eSpark-Backup/getachew-designreview/Docs/Images/Antenna.png

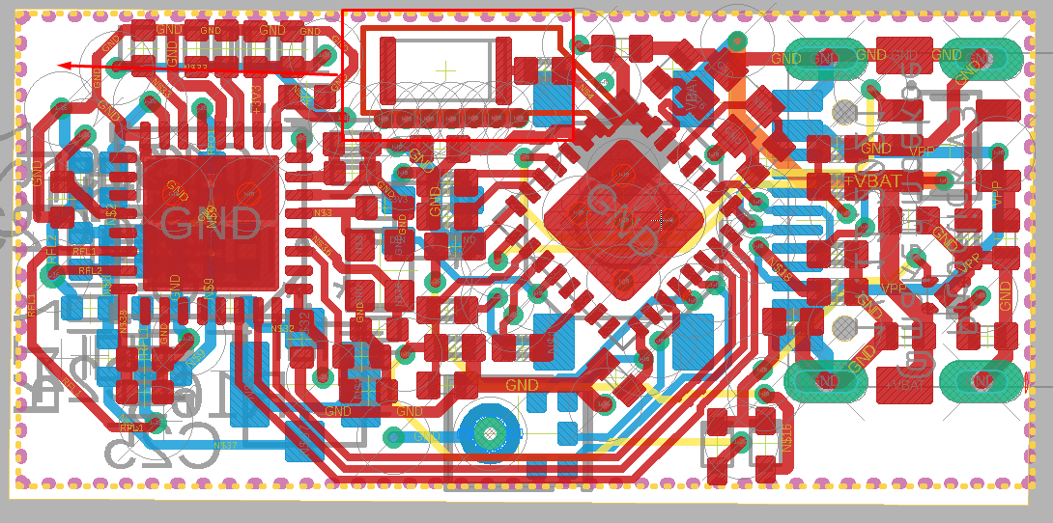
Docs/Images/Antenna.png
