eSpark-Backup/getachew-designreview/Docs/Images/MIC.png

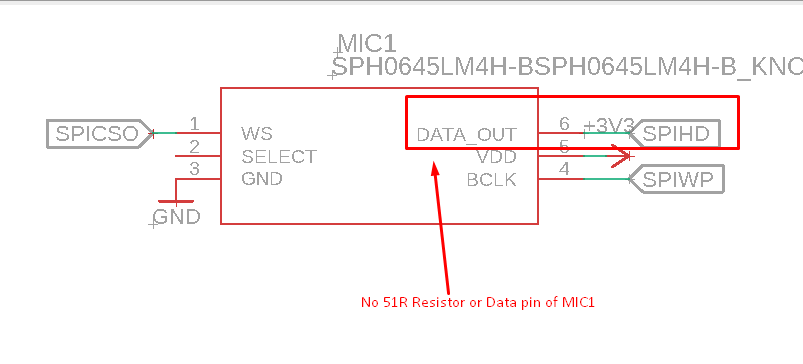
Docs/Images/MIC.png
