eSpark-Backup/getachew-designreview/Docs/Images/R51.png

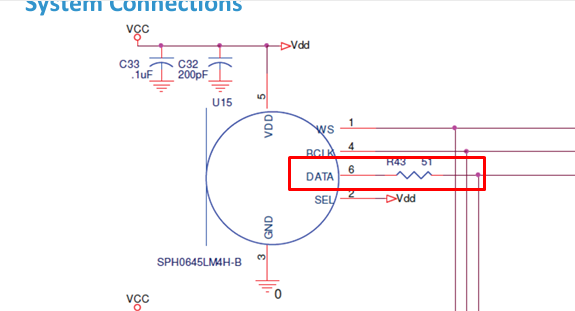
Docs/Images/R51.png
