eSpark-Backup/getachew-designreview/Docs/Images/Shell.png

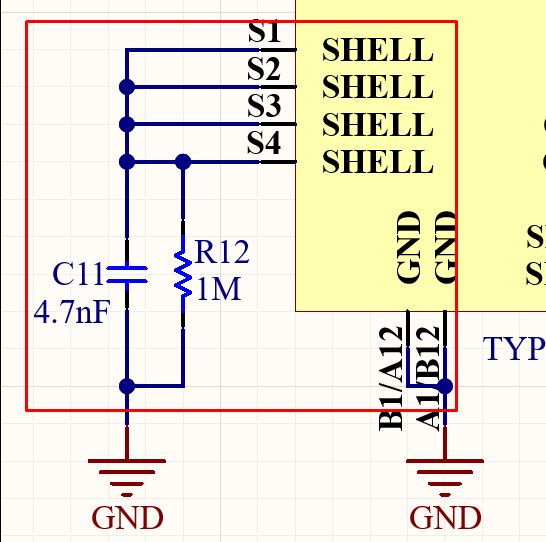
Docs/Images/Shell.png
