eSpark-Backup/getachew-designreview/Docs/Images/Shield.png

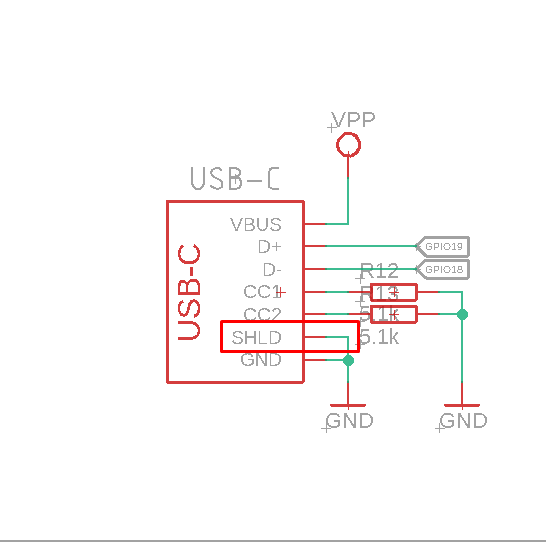
Docs/Images/Shield.png
