eSpark-Backup/getachew-designreview/Design_Files/BOM-esp32-nfc.xlsx

Part | Value | Device | Package | Description | CATEGORY | COPYRIGHT | CURRENT_RATING | DESCRIPTION | MANUFACTURER | MANUFACTURER_PART_NUMBER | MFR_NAME | MPN | OPERATING_TEMP | OPERATING_TEMPERATURE | PART_STATUS | PITCH | POPULARITY | RATING | ROHS_COMPLIANCE | ROHS_COMPLIANT | SERIES | SUB-CATEGORY | SUBCATEGORY | THERMALLOSS | TOLERANCE | TYPE | VALUE | VOLTAGE_RATING
BAT+ | TP/SP-1.5X1.0 | TP/SP-1.5X1.0 | SOLDERPAD_1.5X1.0 | Solderpads/Testpads
BAT- | TP/SP-1.5X1.0 | TP/SP-1.5X1.0 | SOLDERPAD_1.5X1.0 | Solderpads/Testpads
C1 | 1µ | C-EU-0402-WOKEEPOUT_S | C0402_S
C2 | 1µ | C-EU-0402-WOKEEPOUT_S | C0402_S
C3 | 1µ | C-EU-0402-WOKEEPOUT_S | C0402_S
C4 | 1µ | C-EU-0402-WOKEEPOUT_S | C0402_S
C5 |  | C_CHIP-0402(1005-METRIC) | CAPC1005X60 | Capacitor - Generic | Capacitor
C6 |  | C_CHIP-0402(1005-METRIC) | CAPC1005X60 | Capacitor - Generic | Capacitor
C7 | 10µ | C-EU-0402-WOKEEPOUT_S | C0402_S
C8 | 0,1µ | C-EU-0402-WOKEEPOUT_S | C0402_S
C9 | 0,1µ | C-EU-0402-WOKEEPOUT_S | C0402_S
C13 | 1µ | C-EU-0402-WOKEEPOUT_S | C0402_S
C15 |  | C_CHIP-0402(1005-METRIC) | CAPC1005X60 | Capacitor - Generic | Capacitor
C19 |  | C_CHIP-0402(1005-METRIC) | CAPC1005X60 | Capacitor - Generic | Capacitor
C20 | 10p | C-EU-0402-WOKEEPOUT_S | C0402_S
C21 | 10p | C-EU-0402-WOKEEPOUT_S | C0402_S
C22 |  | C_CHIP-0402(1005-METRIC) | CAPC1005X60 | Capacitor - Generic | Capacitor
C23 |  | C_CHIP-0402(1005-METRIC) | CAPC1005X60 | Capacitor - Generic | Capacitor
C24 |  | C_CHIP-0402(1005-METRIC) | CAPC1005X60 | Capacitor - Generic | Capacitor
C25 |  | C_CHIP-0402(1005-METRIC) | CAPC1005X60 | Capacitor - Generic | Capacitor
C26 |  | C_CHIP-0402(1005-METRIC) | CAPC1005X60 | Capacitor - Generic | Capacitor
C27 |  | C_CHIP-0402(1005-METRIC) | CAPC1005X60 | Capacitor - Generic | Capacitor
C28 |  | C_CHIP-0402(1005-METRIC) | CAPC1005X60 | Capacitor - Generic | Capacitor
C29 |  | C_CHIP-0402(1005-METRIC) | CAPC1005X60 | Capacitor - Generic | Capacitor
C30 |  | C_CHIP-0402(1005-METRIC) | CAPC1005X60 | Capacitor - Generic | Capacitor
C31 |  | C_CHIP-0402(1005-METRIC) | CAPC1005X60 | Capacitor - Generic | Capacitor
C32 |  | C_CHIP-0402(1005-METRIC) | CAPC1005X60 | Capacitor - Generic | Capacitor
C33 |  | C_CHIP-0402(1005-METRIC) | CAPC1005X60 | Capacitor - Generic | Capacitor
C34 | 10n | C_CHIP-0402(1005-METRIC) | CAPC1005X60 | Capacitor - Generic | Capacitor
C35 |  | C_CHIP-0402(1005-METRIC) | CAPC1005X60 | Capacitor - Generic | Capacitor
C36 |  | C_CHIP-0402(1005-METRIC) | CAPC1005X60 | Capacitor - Generic | Capacitor
C37 |  | C_CHIP-0402(1005-METRIC) | CAPC1005X60 | Capacitor - Generic | Capacitor
C38 |  | C_CHIP-0402(1005-METRIC) | CAPC1005X60 | Capacitor - Generic | Capacitor
C39 |  | C_CHIP-0402(1005-METRIC) | CAPC1005X60 | Capacitor - Generic | Capacitor
C40 |  | C_CHIP-0402(1005-METRIC) | CAPC1005X60 | Capacitor - Generic | Capacitor
C41 |  | C_CHIP-0402(1005-METRIC) | CAPC1005X60 | Capacitor - Generic | Capacitor
C42 |  | C_CHIP-0402(1005-METRIC) | CAPC1005X60 | Capacitor - Generic | Capacitor
C43 |  | C_CHIP-0402(1005-METRIC) | CAPC1005X60 | Capacitor - Generic | Capacitor
D1 | 4148 | DIODE-SOD523 | SOD523 | DIODE |  |  |  |  |  |  |  |  |  |  |  |  | 3
D2 | 4148 | DIODE-SOD523 | SOD523 | DIODE |  |  |  |  |  |  |  |  |  |  |  |  | 3
ESP1 | ESP32_C3_QFN32 | ESP32_C3_QFN32 | QFN32
F2 | 0 | R-EU-0402-WOKEEPOUT | R0402
J4 | UMC-JACK | A-1JB | A-1JB | U.FL (UMCC), AMC Connector Jack, Male Pin 50Ohm Surface Mount Solder | RF Connectors / Coaxial Connectors |  |  | RF Connectors / Coaxial Connectors AMC PCB JACK S/M T&R U.FL Compatible | Amphenol RF |  |  | A-1JB |  | 40°C TO +90°C | Active | - |  |  | RoHS3 Compliant |  | AMC |  | RF Connectors / Coaxial Connectors |  |  | Jack, Male Pin, Surface Mount | UMC-JACK
L1 | WS2812_2020 | WS2812_2020 | WS2812_2020
L3 |  | L_CHIP-0402(1006-METRIC) | INDC1006X60N | Inductor Fixed - Generic | Inductor |  |  |  |  |  |  |  |  |  |  |  |  |  |  |  |  | Fixed
L4 |  | L_CHIP-0402(1006-METRIC) | INDC1006X60N | Inductor Fixed - Generic | Inductor |  |  |  |  |  |  |  |  |  |  |  |  |  |  |  |  | Fixed
MIC1 | SPH0645LM4H-BSPH0645LM4H-B_KNO | SPH0645LM4H-BSPH0645LM4H-B_KNO | SPH0645LM4H-B_KNO |  |  | Copyright (C) 2024 Ultra Librarian. All rights reserved. |  |  |  | SPH0645LM4H-B | Knowles
R/1 | 1M | R-EU-0402-WOKEEPOUT | R0402
R/2 | 250k | R-EU-0402-WOKEEPOUT | R0402
R1 | 1k | R-EU-0402-WOKEEPOUT | R0402
R2 | 1k | R-EU-0402-WOKEEPOUT | R0402
R3 | 1M | R-EU-0402-WOKEEPOUT | R0402
R4 | 10k | R-EU-0402-WOKEEPOUT | R0402
R5 | 47.5k | R-EU-0402-WOKEEPOUT | R0402
R7 | 10k | R-EU-0402-WOKEEPOUT | R0402
R10 | 10k | R-EU-0402-WOKEEPOUT | R0402
R11 | 10k | R-EU-0402-WOKEEPOUT | R0402
R12 | 5.1k | R-EU-0402-WOKEEPOUT | R0402
R13 | 5.1k | R-EU-0402-WOKEEPOUT | R0402
R16 |  | R_CHIP-0402(1005-METRIC) | RESC1005X40 | Resistor Fixed - Generic | Resistor |  |  |  |  |  |  |  |  |  |  |  |  |  |  |  |  | Fixed
R17 |  | R_CHIP-0402(1005-METRIC) | RESC1005X40 | Resistor Fixed - Generic | Resistor |  |  |  |  |  |  |  |  |  |  |  |  |  |  |  |  | Fixed
RF | ANT3216LL00R2400A | ANT3216LL00R2400A | ANT3216LL00R2400A
U$1 | BUTTON_ST-1187-3 | BUTTON_ST-1187-3 | BUTTON_ST-1187-3
U1 | BRCL4054BME | MCP73831_SOT23_5 | SOT23-5
U2 | MIC5504 | MIC5504 | TDFN4
U3 | NX2016SA-27.12MHZ-EXS00A-CS113SMD04_NX2016S_NDK | NX2016SA-27.12MHZ-EXS00A-CS113SMD04_NX2016S_NDK | SMD04_NX2016S_NDK |  |  | Copyright (C) 2024 Ultra Librarian. All rights reserved. |  |  |  | NX2016SA-27.12MHZ-EXS00A-CS11337 | NDK
U7 | ST25R3916B-AQWTVFQFPN32_5X5_WETTABLE_STM-L | ST25R3916B-AQWTVFQFPN32_5X5_WETTABLE_STM-L | VFQFPN32_5X5_WETTABLE_STM-L |  |  | Copyright (C) 2024 Ultra Librarian. All rights reserved. |  |  |  | ST25R3916B-AQWT | STMicroelectronics |  |  |  |  |  |  |  |  |  |  |  |  |  |  | RFID, RF Access, Monitoring ICs
USB-C | USB_C_C393939 | USB_C_C393939 | USBC_C393939
X1 | XTAL_2016 | XTAL_2016 | XTYL_2016
