eSpark-Backup/getachew-designreview/(list of files, drawings)

Other design files:
Design_Files/Imported esp32 nfc pcb.PrjPcb/esp32 nfc pcb.PcbDoc
Design_Files/Imported esp32 nfc pcb.PrjPcb/esp32 nfc pcb.PrjPcb
