eSpark-Backup/getachew-designreview/Client Files/esp32 nfc pcb.brd

## EAGLE design Client Files/esp32 nfc pcb.brd (2024-08-23)

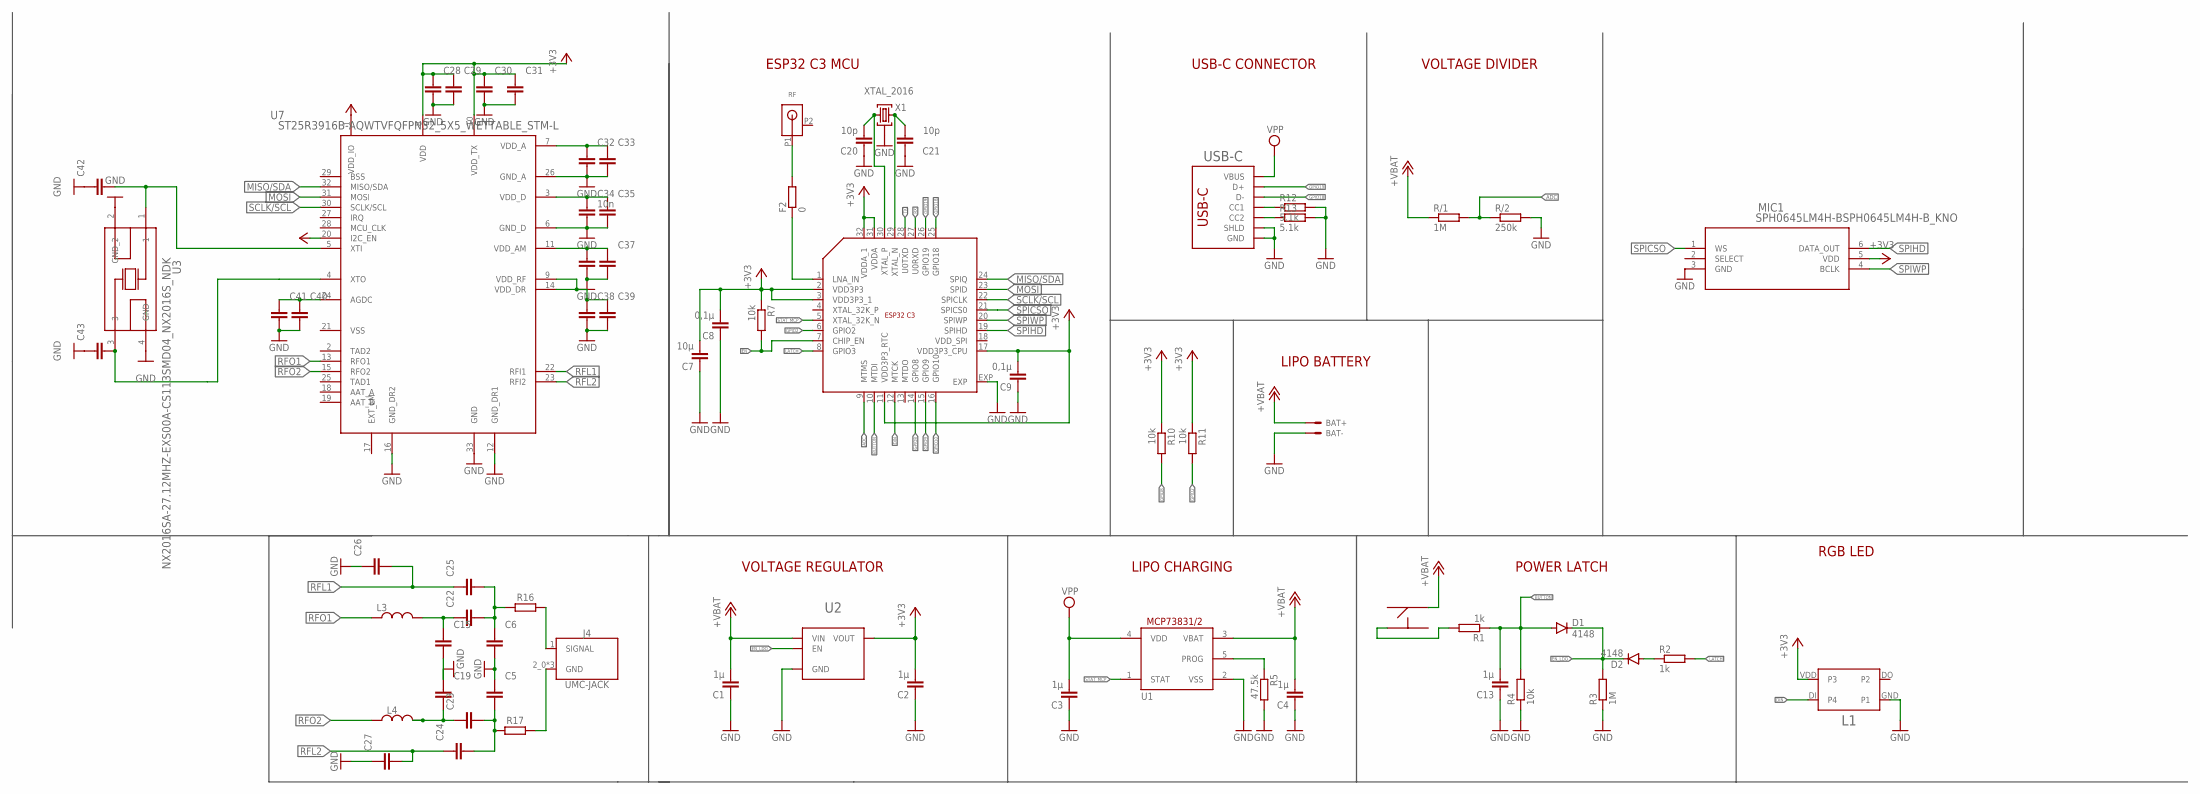
[picture p10: schematic esp32 nfc.sch]

Parts:
BAT+: TP/SP-1.5X1.0; SOLDERPAD_1.5X1.0
BAT-: TP/SP-1.5X1.0; SOLDERPAD_1.5X1.0
C1, C2, C3, C4, C13: 1µ; C0402_S
C5, C6, C15, C19, C22, C23, C24, C25, C26, C27, C28, C29, C30, C31, C32, C33, C35, C36, C37, C38, C39, C40, C41, C42, C43: C_CHIP-0402(1005-METRIC); CAPC1005X60
C7: 10µ; C0402_S
C8, C9: 0,1µ; C0402_S
C20, C21: 10p; C0402_S
C34: 10n; CAPC1005X60
D1, D2: 4148; SOD523
ESP1: ESP32_C3_QFN32; QFN32
F2: 0; R0402
J4: UMC-JACK; A-1JB
L1: WS2812_2020
L3, L4: L_CHIP-0402(1006-METRIC); INDC1006X60N
MIC1: SPH0645LM4H-BSPH0645LM4H-B_KNO; SPH0645LM4H-B_KNO
R1, R2: 1k; R0402
R3: 1M; R0402
R4, R7, R10, R11: 10k; R0402
R5: 47.5k; R0402
R12, R13: 5.1k; R0402
R16, R17: R_CHIP-0402(1005-METRIC); RESC1005X40
R/1: 1M; R0402
R/2: 250k; R0402
RF: ANT3216LL00R2400A
U1: BRCL4054BME; SOT23-5
U2: MIC5504; TDFN4
U3: NX2016SA-27.12MHZ-EXS00A-CS113SMD04_NX2016S_NDK; SMD04_NX2016S_NDK
U7: ST25R3916B-AQWTVFQFPN32_5X5_WETTABLE_STM-L; VFQFPN32_5X5_WETTABLE_STM-L
U$1: BUTTON_ST-1187-3
USB-C: USB_C_C393939; USBC_C393939
X1: XTAL_2016; XTYL_2016

Connections:
+3V3: C2.P$2 (2), C7.P$2 (2), C8.P$2 (2), C9.P$2 (2), C28.1, C29.1, C30.1, C31.1, ESP1.2 (VDD3P3), ESP1.3 (VDD3P3_1), ESP1.11 (VDD3P3_RTC), ESP1.17 (VDD3P3_CPU), ESP1.31 (VDDA), ESP1.32 (VDDA_1), L1.VDD (P3), MIC1.5 (VDD), R7.1, R10.1, R11.1, U2.P1 (VOUT), U7.1 (VDD_IO), U7.8 (VDD), U7.10 (VDD_TX), U7.20 (I2C_EN)
+VBAT: BAT+.1, C1.P$2 (2), C4.P$2 (2), R/1.1, U1.3 (VBAT), U2.P4 (VIN), U$1.P2
ADC: ESP1.9 (MTMS), R/1.2, R/2.1
BUTTON: C13.P$2 (2), D1.A, ESP1.10 (MTDI), R1.1, R4.2
DIN: ESP1.12 (MTCK), L1.DI (P4)
EN: ESP1.7 (CHIP_EN), R7.2
EN_LDO: D1.C, D2.C, R3.2, U2.P3 (EN)
GND: BAT-.1, C1.P$1 (1), C2.P$1 (1), C3.P$1 (1), C4.P$1 (1), C5.1, C6.2, C7.P$1 (1), C8.P$1 (1), C9.P$1 (1), C13.P$1 (1), C15.2, C19.1, C20.P$1 (1), C21.P$1 (1), C26.1, C27.1, C28.2, C29.2, C30.2, C31.2, C32.2, C33.2, C34.2, C35.2, C36.2, C37.2, C38.2, C39.2, C40.2, C41.2, C42.1, C43.1, ESP1.EXP, L1.GND (P1), MIC1.3 (GND), R3.1, R4.1, R5.2, R12.2, R13.2, R/2.2, U1.2 (VSS), U2.EXP (GND), U2.P2 (GND), U3.2 (GND_2), U3.4 (GND), U7.6 (GND_D), U7.12 (GND_DR1), U7.16 (GND_DR2), U7.26 (GND_A), U7.33 (GND), USB-C.A1B12 (GND), USB-C.B1A12 (GND), USB-C.S1 (SHLD), USB-C.S2 (SHLD), USB-C.S3 (SHLD), USB-C.S4 (SHLD), X1.P2 (G), X1.P4 (G)
GPIO2: ESP1.6 (GPIO2), R11.2
GPIO8: ESP1.14 (GPIO8), R10.2
GPIO9: ESP1.15 (GPIO9)
GPIO10: ESP1.16 (GPIO10)
GPIO18: ESP1.25 (GPIO18), USB-C.A7 (D-), USB-C.B7 (D-)
GPIO19: ESP1.26 (GPIO19), USB-C.A6 (D+), USB-C.B6 (D+)
LATCH: ESP1.8 (GPIO3), R2.2
MISO/SDA: ESP1.22 (SPICLK), U7.32 (MISO/SDA)
MOSI: ESP1.23 (SPID), U7.31 (MOSI)
unnamed: R1.2, U$1.P3
unnamed: C19.2, C23.1, L4.2
unnamed: C42.2, U3.1, U7.5 (XTI)
unnamed: ESP1.1 (LNA_IN), F2.1
unnamed: C15.1, C22.1, L3.2
unnamed: F2.2, RF.P1 (ANT)
unnamed: C32.1, C33.1, U7.7 (VDD_A)
unnamed: C5.2, C23.2, C24.2, R17.1
unnamed: C6.1, C22.2, C25.2, R16.1
unnamed: D2.A, R2.1
unnamed: R13.1, USB-C.B5 (CC2)
unnamed: R5.1, U1.5 (PROG)
unnamed: R12.1, USB-C.A5 (CC1)
unnamed: C20.P$2 (2), ESP1.30 (XTAL_P), X1.P1 (1)
unnamed: C21.P$2 (2), ESP1.29 (XTAL_N), X1.P3 (2)
unnamed: C34.1, C35.1, U7.3 (VDD_D)
unnamed: C36.1, C37.1, U7.11 (VDD_AM)
unnamed: J4.1 (SIGNAL), R16.2
unnamed: C38.1, C39.1, U7.9 (VDD_RF), U7.14 (VDD_DR)
unnamed: C43.2, U3.3, U7.4 (XTO)
unnamed: J4.2_0 (GND), J4.2_1 (GND), J4.2_2 (GND), R17.2
unnamed: C40.1, C41.1, U7.24 (AGDC)
RFL1: C25.1, C26.2, U7.22 (RFI1)
RFL2: C24.1, C27.2, U7.23 (RFI2)
RFO1: L3.1, U7.13 (RFO1)
RFO2: L4.1, U7.15 (RFO2)
RX: ESP1.27 (U0RXD)
SCLK/SCL: ESP1.24 (SPIQ), U7.30 (SCLK/SCL)
SPICSO: ESP1.21 (SPICS0), MIC1.1 (WS)
SPIHD: ESP1.19 (SPIHD), MIC1.6 (DATA_OUT)
SPIWP: ESP1.20 (SPIWP), MIC1.4 (BCLK)
STAT_MCP: ESP1.5 (XTAL_32K_N), U1.1 (STAT)
TX: ESP1.28 (U0TXD)
VPP: C3.P$2 (2), U1.4 (VDD), USB-C.A4B9 (VBUS), USB-C.B4A9 (VBUS)

Notes on the sheet:
VOLTAGE DIVIDER
LIPO CHARGING
VOLTAGE REGULATOR
POWER LATCH
RGB LED
USB-C CONNECTOR
ESP32 C3 MCU
LIPO BATTERY

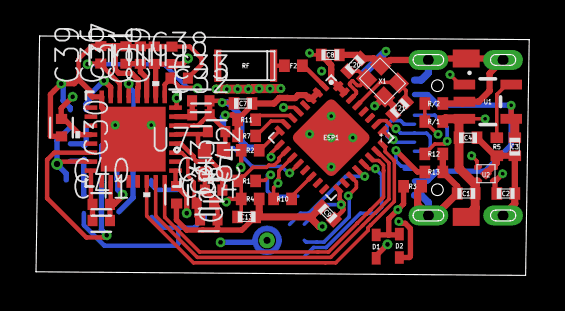
[picture p11: board esp32 nfc pcb.brd from above]

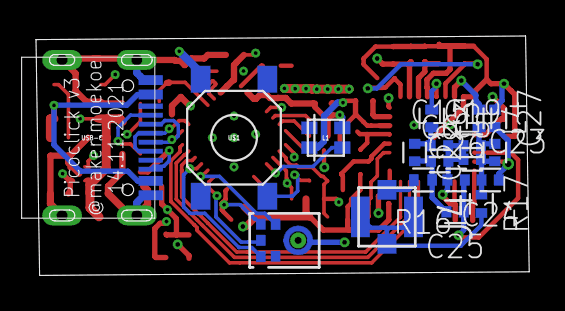
[picture p12: board esp32 nfc pcb.brd from below]

Board: 4 copper layers, 27.4 x 13.3 mm, 69 parts (19 on the bottom side), 47 nets.
