eSpark-Backup/getachew-designreview/(commit log)

2024-08-23 #1 Client Files and Review Report added.
    [BOM-esp32-nfc.xlsx, esp32 nfc pcb.PcbDoc, esp32 nfc pcb.PrjPcb, esp32 nfc pcb.brd, esp32 nfc.csv, esp32 nfc.sch]
2024-08-23 Folder Structure corrected.
    [BOM-esp32-nfc.xlsx, esp32 nfc pcb.PcbDoc, esp32 nfc pcb.PrjPcb, esp32 nfc.csv]
