eSpark-Backup/getachew-designreview/(notices)

Notices in the files:
parts and their libraries:
Library: COPYRIGHT: Copyright (C) 2024 Ultra Librarian. All rights reserved.
